IEmonoken/TimerCamera-Tank/README.md

# TimerCamera-Tank
M5シリーズのTimerCamera-Xを搭載したタンクを製作する。

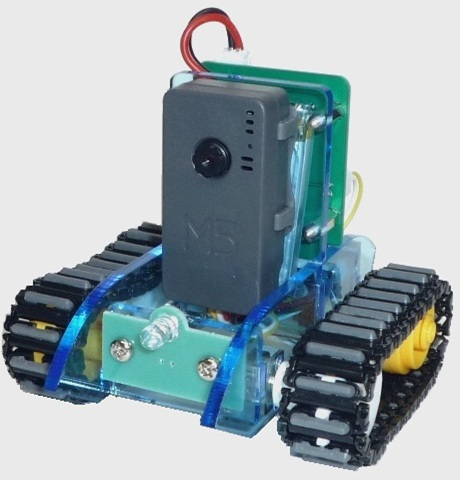
[picture p1: picture.png]
外観
