IEmonoken/TimerCamera-Tank/hardware/README.md

# TimerCamera-Tankのハードウェア
TimerCamera-Tankのハードウェアは工業高校に導入されている工作機器を使って製作できる。

## コンテンツ
* body: TimerCamera-Tankの筐体データ。3mm厚の透明アクリル板をレーザカッターで切断し組み立てる。
* driver: ドライバ基板に関連するデータ。
* driving_wheel: キャタピラの駆動ホイールは3Dプリンタで出力する。
* pcb-opt: タンク前後のLED基板製造データ。LED基板は基板加工機で作る。
