IEmonoken/TimerCamera-Tank/hardware/driver/README.md

# ドライバ基板について
TimerCameraとドライバ基板はGROVEインタフェースで接続される。ドライバ基板はI2Cデバイスとして動作するが、GROVEインタフェースを通じてimerCameraに電源を供給し、TimerCameraからの指令に従ってタンクを動作させる役割をもつ。

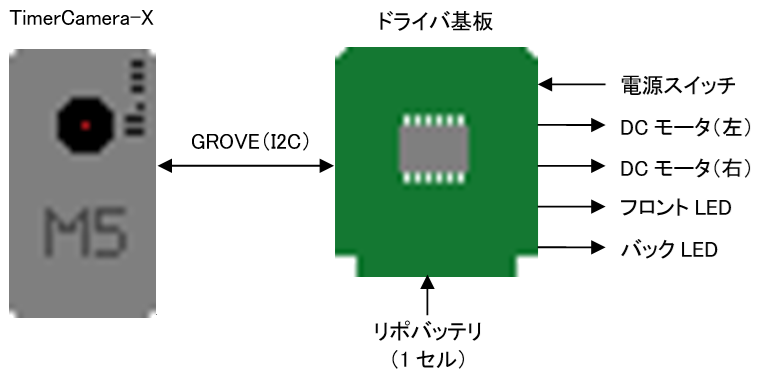
[picture p2: hardware/driver/configuration.png]


> [!NOTE]
> TimerCamera内蔵のリポバッテリは外してある。

## 機能
1. 電源制御:　1セルのリポバッテリーを搭載し、TimerCameraに電源を供給する。またバッテリー電圧が低下したらLEDが早く点灯し充電を促す。
1. モータ駆動:　PWM制御によりキャタピラを駆動するDCモータの回転速度を変える。
1. LEDスイッチ:　タンク前後のLEDを点灯/消灯する。

## プログラミング
TimerCameraTankのプログラムはArduino IDEで作成しアップロードする。スケッチと同じフォルダに`TimerCametraTank.h`と`TimerCametraTank.cpp`を置く。

### 関数
- 左右のDCモータのスピードを-255から255までの整数で設定する。0でDCモータは停止し、255で最高速度となる。また負の数値を設定するとDCモータは逆転する。
```
// speedは-255から255までの整数。範囲を超えた数値を指定すると最高速度となる。
Tank.setLeftMotor(int speed);
Tank.setRightMotor(int speed);
```
- タンク前後のLEDを点灯/消灯する。
```
// turn_onがtrueでLEDが点灯する。turn_onがfalseでLEDが消灯する。
Tank.setFRONT(bool turn_on);
Tank.setBACK(bool turn_on);
```
