IEmonoken/TimerCamera-Tank/hardware/driver/部品配置図.pdf

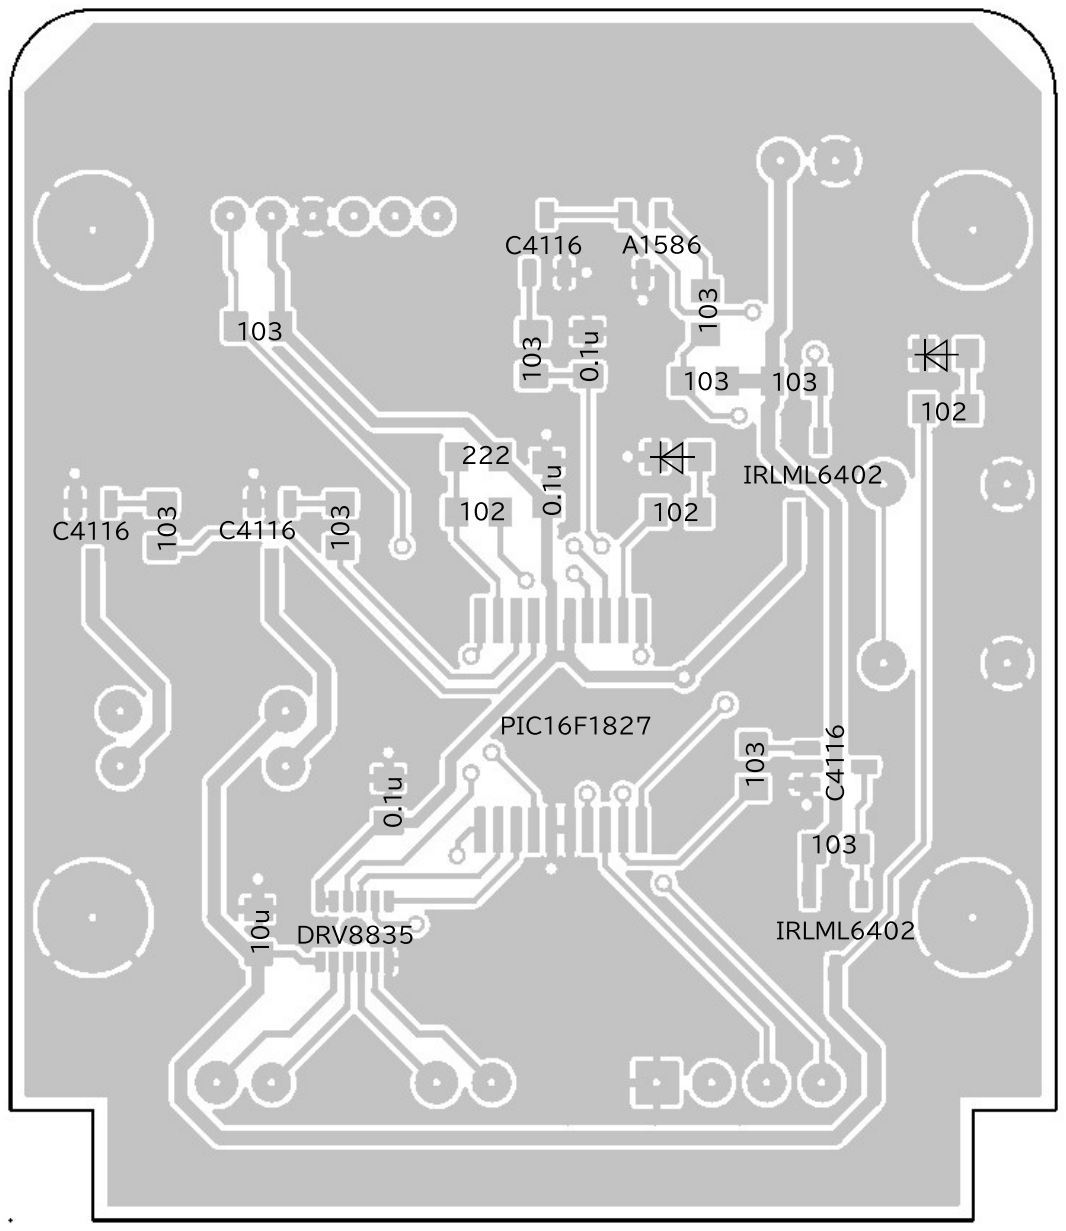
[picture p3: page 1]
