IEmonoken/TimerCamera-Tank/hardware/body/parts.dxf

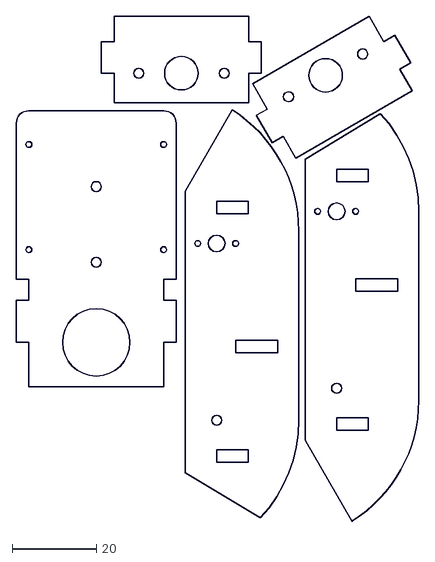
[picture p4: CAD file, 2026-02-15]
hardware/body/parts.dxf
95.6 x 120.1
