IEmonoken/TimerCamera-Tank/hardware/driving_wheel/driving_wheel_14.stl

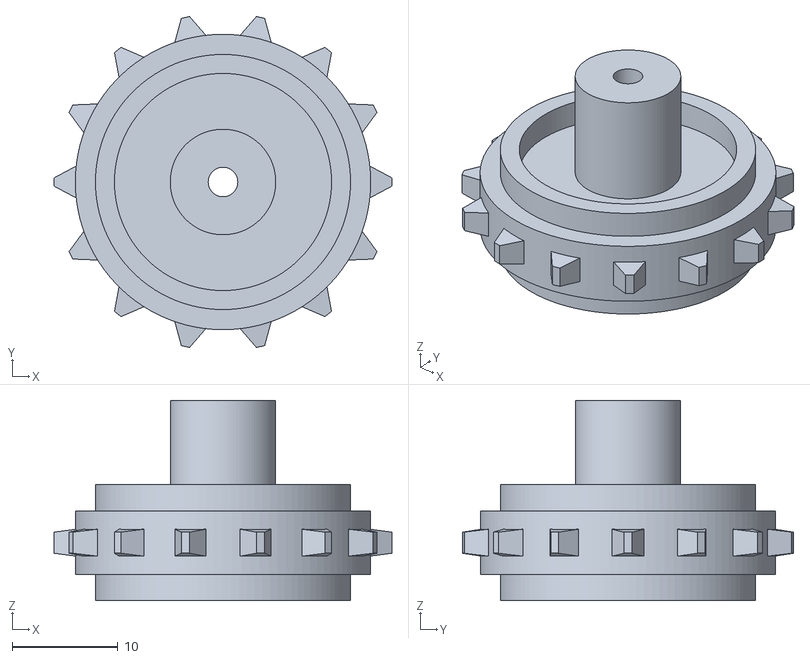
[picture p5: CAD file, 2026-02-15]
hardware/driving_wheel/driving_wheel_14.stl
32.0 x 31.4 x 19.0
