IEmonoken/TimerCamera-Tank/hardware/driver/kicad/driver.kicad_pcb

## KiCad design hardware/driver/kicad/driver.kicad_pcb (2026-02-15)

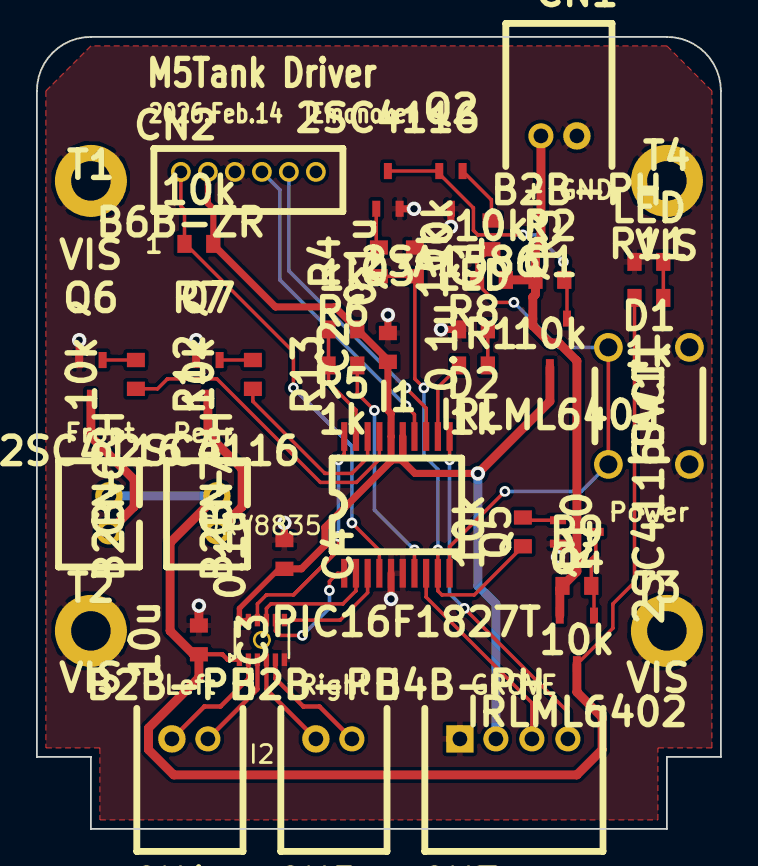
[picture p6: board driver.kicad_pcb from above]

Board: 2 copper layers, 38.0 x 44.0 mm, 40 parts (0 on the bottom side), 35 nets.

Parts:
C1, C2, C4: 0.1u; chip1608
C3: 10u; chip1608
CN1, CN4, CN5: B2B-PH; S2B-PH
CN2: B6B-ZR; B6B-ZH
CN3: B4B-PH; S4B-PH
CN6, CN7: B2B-PH
D1, D2: LED; chip1608
I1: PIC16F1827T; SOP20-0.65
I2: DRV8835
Q1, Q4: IRLML6402; SOT3-0.95-GSD
Q2: 2SA1586; SOT3-0.65-BEC
Q3, Q5, Q6, Q7: 2SC4116; SOT3-0.65-BEC
R1, R2, R3, R4, R7, R9, R10, R12, R13: 10k; chip1608
R5, R6, R8, R11: 1k; chip1608
SW1: TACT; SW-tact
T1, T2, T3, T4: VIS; vis20-g

Connections:
APAHSE: I1.20, I2.10
APWM: I1.2, I2.9
A_EN: I1.7, R6.2
BACK: I1.18, R13.2
BPAHSE: I1.1, I2.8
BPWM: I1.3, I2.7
FRONT: I1.17, R12.2
GND: C1.1, C2.2, C3.1, C4.1, CN1.1, CN2.3, CN3.1, D1.2, D2.2, I1.5, I1.6, I2.6, I2.PAD, Q2.C, Q3.E, Q5.E, Q6.E, Q7.E, SW1.1, T1.1, T2.1, T3.1, T4.1
LED: I1.12, R8.1
N00000: Q1.G, Q2.E, Q3.C, R2.2
N00001: CN5.1, I2.4
N00002: CN5.2, I2.5
N00003: CN4.1, I2.2
N00004: CN4.2, I2.3
N00005: CN2.1, I1.4, R7.2
N00006: CN2.4, I1.14
N00007: CN2.5, I1.13
N00008: Q2.B, R3.1
N00009: Q3.B, R4.2
N00010: Q4.G, Q5.C, R9.2
N00011: Q5.B, R10.1
N00012: D1.1, R11.2
N00013: D2.1, R8.2
N00014: Q6.B, R12.1
N00015: Q7.B, R13.1
N00016: CN6.2, Q6.C
N00017: CN7.2, Q7.C
P_EN: C1.2, I1.9, R4.1, R10.2
P_SW: I1.10, R1.2, R3.2, SW1.2
SCL: CN3.4, I1.11
SDA: CN3.3, I1.8
VBAT: CN1.2, Q1.S, Q4.S, R1.1, R2.1, R9.1
VCC: C2.1, C4.2, CN2.2, CN3.2, I1.15, I1.16, I2.11, I2.12, Q1.D, R5.1, R7.1
VM: C3.2, CN6.1, CN7.1, I2.1, Q4.D, R11.1
VP: I1.19, R5.2, R6.1
